drhenrich/artificial-nose/(commit log)

2026-10-25 Add concept for FlyWire olfactory SNN on Tang Nano 20K cluster (Lite3)
    Concept document plus a numpy-only analysis script that measures the
    model tensors, connectome sparsity and per-board BSRAM budget.
    Claude-Session: https://claude.ai/code/session_01WqW1PKsRP1W6o2UytDiWsr
2026-10-25 Align SNN-FPGA concept with modeling_snn.py
    Norse default LIF parameters confirmed; recurrent weights are not
    sign-constrained, so store signed weights per synapse; input current is
    W_in·(spike*rate); per-sample min-max encoding needs an intensity gate
    on the MCU. inspect_model.py now analyzes effective recurrent weights
    and proposes power-of-two scales.
    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
2026-10-25 Use real model numbers in SNN-FPGA concept
    692 classes, 14998 synapses (2.34 % density), test accuracy 47.6 %;
    updated memory budget, timing and a single-board variant.
    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
2026-10-25 Add float and bit-exact fixed-point reference model
    snn_ref.py mirrors modeling_snn.py in numpy and defines the fixed-point
    arithmetic the HDL must implement; verify_torch.py checks the float
    model against the original PyTorch/Norse implementation.
    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
    [snn_ref.py, verify_torch.py]
2026-10-25 Work out single-board variant E and E-cluster
    VARIANTE-E.md details memory map (41/46 BSRAM blocks, readout in
    SDRAM), step schedule, timing, resources and loading; the
    export_variant_e.py script writes and round-trip checks the memory
    images. E/F become the recommended architecture.
    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
2026-10-25 Fix LIF update order to match Norse 1.1.0; configurable fixed-point format
    verify_torch.py against modeling_snn.py with Norse 1.1.0 showed that
    input current is added before the membrane update. Float reference now
    matches PyTorch to 2e-7. --frac selects the int16 state format to avoid
    saturation.
    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
    [export_variant_e.py, snn_ref.py]
2026-10-25 Add measurements from the published model weights
    Torch check passes (5e-6); 46 % of recurrent signs differ from the
    connectome; Q8.7 avoids saturation and becomes the default; INT8 error
    is below the Poisson Monte-Carlo noise; 36 % of synapses round to zero.
    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
    [export_variant_e.py, snn_ref.py]
2026-10-25 Add Variant E Verilog core, testbenches and Tang Nano 20K bring-up
    snn_core.v implements fixed_forward() bit-exactly (Verilator: 2000 steps,
    all spikes and logits match). 9-bit w_in/w_rec with half-split synapse
    lists. Bring-up top streams spike counts over UART; build.sh produces a
    bitstream with yosys/nextpnr-himbaechel/gowin_pack (21 % LUT, 37 BSRAM,
    Fmax 58 MHz). board_test.py checks the board against snn_ref.py.
    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
    [board_test.py, export_variant_e.py, snn_core.v, snn_ref.py, tb_snn_core.v, tb_top.v, top_tangnano20k.v]
2026-10-25 Record successful Tang Nano 20K bring-up (10/10 samples bit-exact)
    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
2026-10-25 Faster core, SDRAM readout, full Tang Nano 20K top and sensor retraining pipeline
    - snn_core: parallel synapse halves, 4 input weights/cycle, pipelined MACs,
    pointer prefetch: 3.04M -> 1.72M cycles (31.8 ms at 54 MHz), bit-exact
    - sdram_ctrl + behavioral SDRAM model with protocol/timing checks
    - top_tangnano20k_full: 54 MHz PLL, UART commands W/R/C, on-FPGA readout;
    full-system simulation bit-exact; bitstream meets timing (61.8 MHz)
    - board_test.py full mode (SDRAM load, readback, logit comparison)
    - sensor_features, record_sensors, train_sensor_snn (frozen connectome),
    nose_bridge (live/replay, optional ROS 2); verified with synthetic data
    - docs: VARIANTE-E.md, SENSORIK.md, READMEs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
2026-10-25 Runtime SDRAM read latency with burst calibration; L/B/Z diagnostics
    First board run of the full design: SDRAM single-word readback was correct
    but all logits were wrong, consistent with an off-by-one burst read latency.
    rd_lat is now set over UART ('L'), bursts can be read back ('B') and spike
    counts fetched ('Z'). board_test.py and nose_bridge.py calibrate the latency
    after loading and localize core vs. readout errors. Simulation: only latency 3
    matches the SDRAM model; all regressions pass.
    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
    [board_test.py, nose_bridge.py, sdram_ctrl.v, snn_core.v, tb_sdram.v, tb_snn_core.v, tb_top_full.v, top_tangnano20k.v]
2026-10-25 SDRAM read capture on falling edge, half-cycle calibration
    Second board run: burst capture at 2 cycles was 27 % correct, at >= 3 cycles
    almost never, i.e. the sample point sat on the data transition. The controller
    can now also sample on the falling clock edge (half a cycle earlier); the
    'L' command takes latency + edge, and board_test.py/nose_bridge.py sweep
    1.5..7.0 cycles in half-cycle steps and pick the centre of the longest
    error-free window. Simulation passes; both bitstreams meet 54 MHz.
    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
    [board_test.py, sdram_ctrl.v, tb_sdram.v, tb_top_full.v, top_tangnano20k_full.v]
2026-10-25 Record full-design board success; default SDRAM capture 2.5 cycles falling edge
    Board run v3: calibration found a single error-free sample point (2.5 cycles,
    falling edge); 10/10 samples with all 692 logits and classes bit-exact,
    66 ms per sample including UART.
    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
    [top_tangnano20k_full.v]
